kristspo/ATmega328P_with_PCA9685/README.md

## ATmega 328P with PCA9685 PWM controller

Documentation and example code for Arduino compatible ATmega 328P development board with with PCA9685 PWM controller. Development board is available at [Tindie](https://www.tindie.com/products/11012).

[Documentation](documentation) directory contains 'read me' usage notes, board schematic and PCA9685 datasheet. [Example code](example_code) directory has Arduino IDE sample code for led fading and servo control.
