kristspo/ATmega328P_with_PCA9685/example_code/Servo_PCA_Knob/README.md

### Servo_PCA_Knob

Example Arduino sketch controls one or more servos attached to PCA9685 according to potentiometer rotation read form analog pin. Servo limits are set by SERVO_PULSE_MIN and SERVO_PULSE_MAX defines. Sketch can be used to adjust and test servo rotation limits. Adafruit PWM Servo Driver Library is used to control PCA9685.

Code is provided "AS IS", without warranty of any kind that it will be useful for your purpose.
