kristspo/ATmega328P_with_PCA9685/documentation/ATmega_PCA9685_schematic.pdf

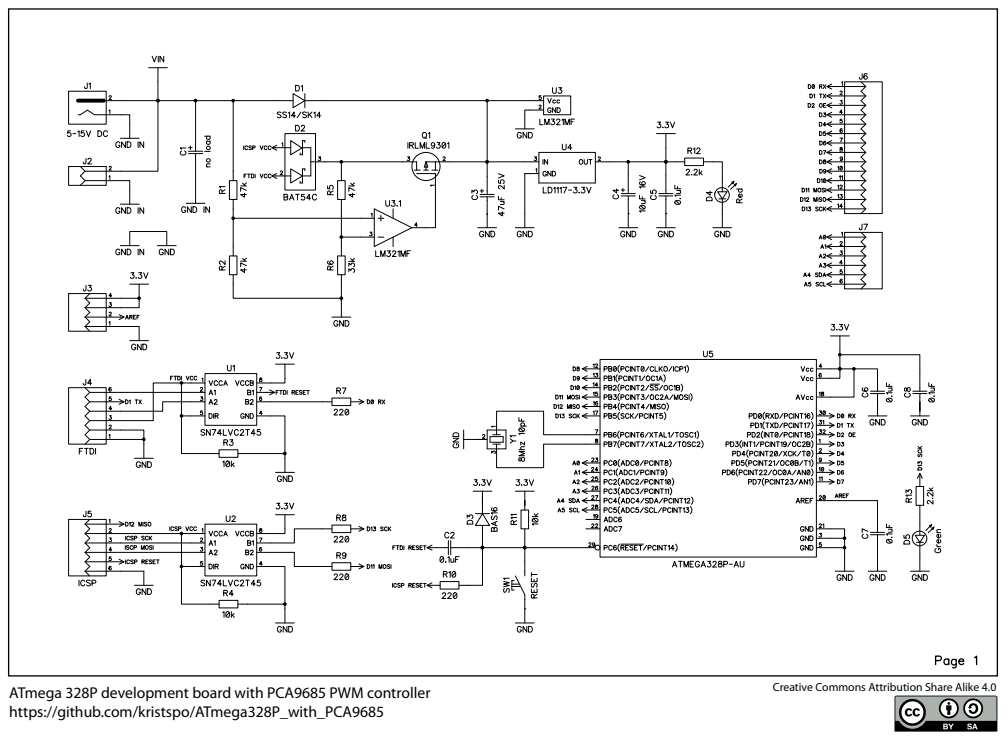
[picture p4: page 1]

ATmega 328P development board with PCA9685 PWM controller
https://github.com/kristspo/ATmega328P_with_PCA9685

Creative Commons Attribution Share Alike 4.0

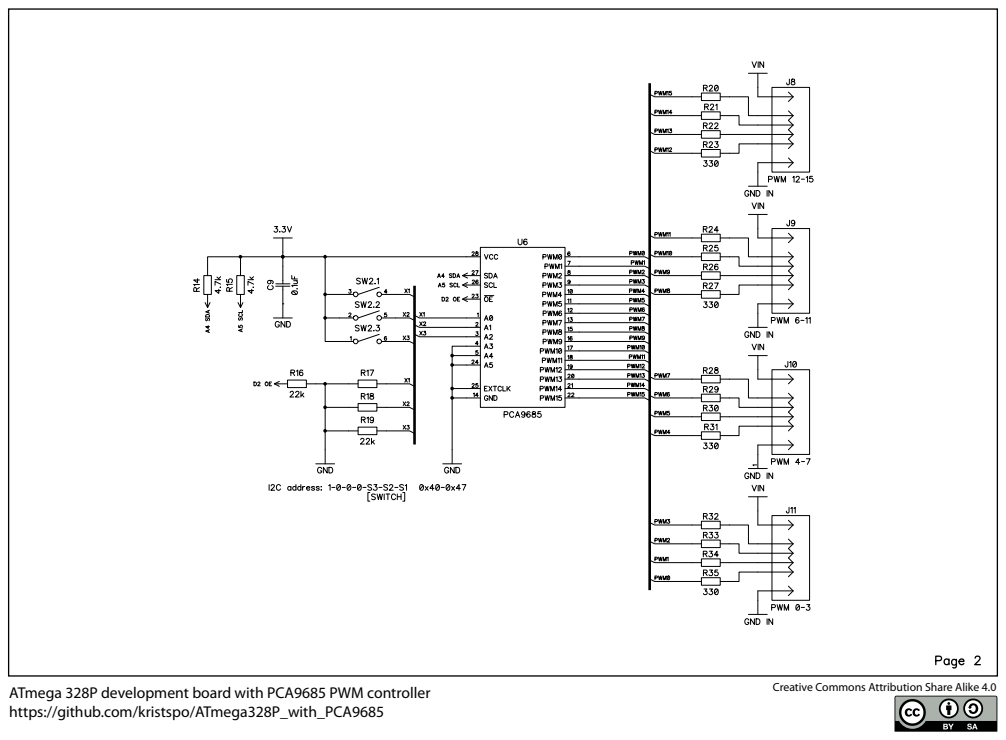
[picture p5: page 2]

ATmega 328P development board with PCA9685 PWM controller
https://github.com/kristspo/ATmega328P_with_PCA9685

Creative Commons Attribution Share Alike 4.0
